xiaolaba/UNO-R1-R3-reset-circuitry/hack/UNO_Rev1_2_3_mod.pdf

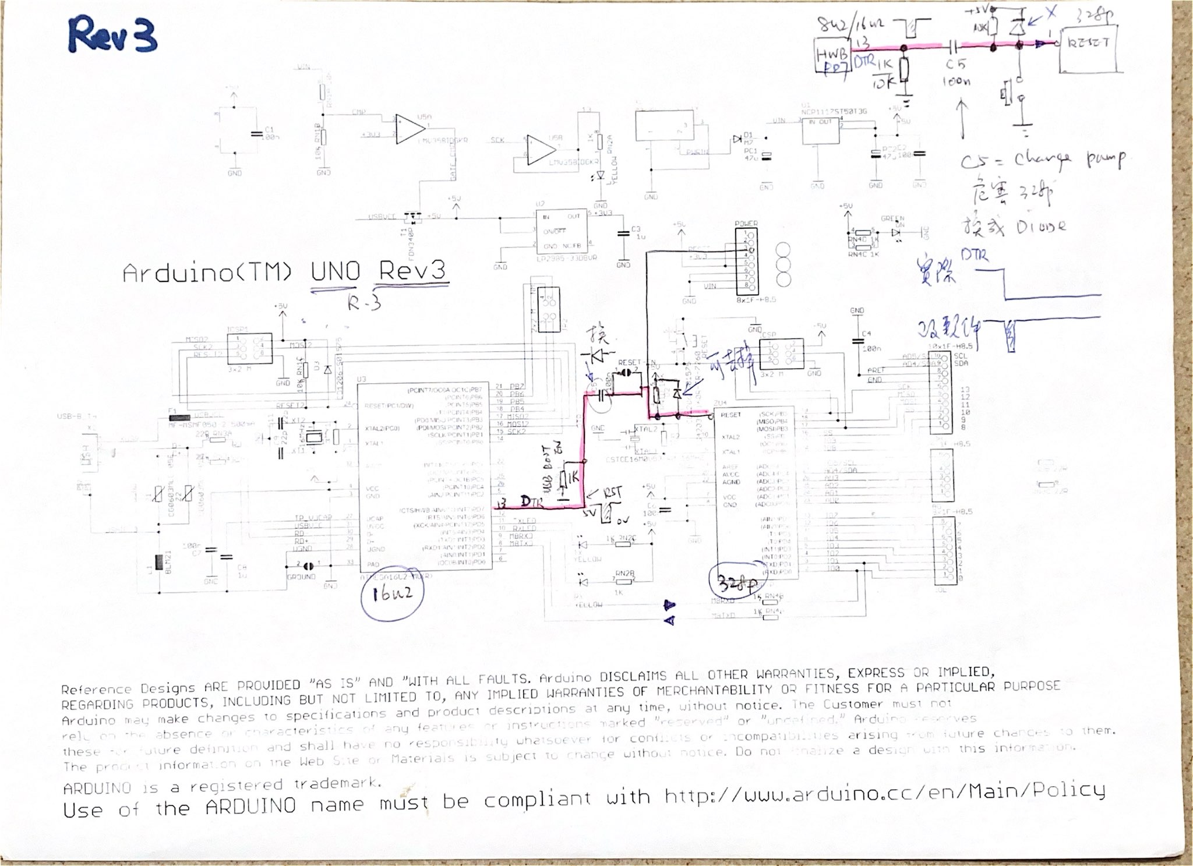
[picture p12: figure]

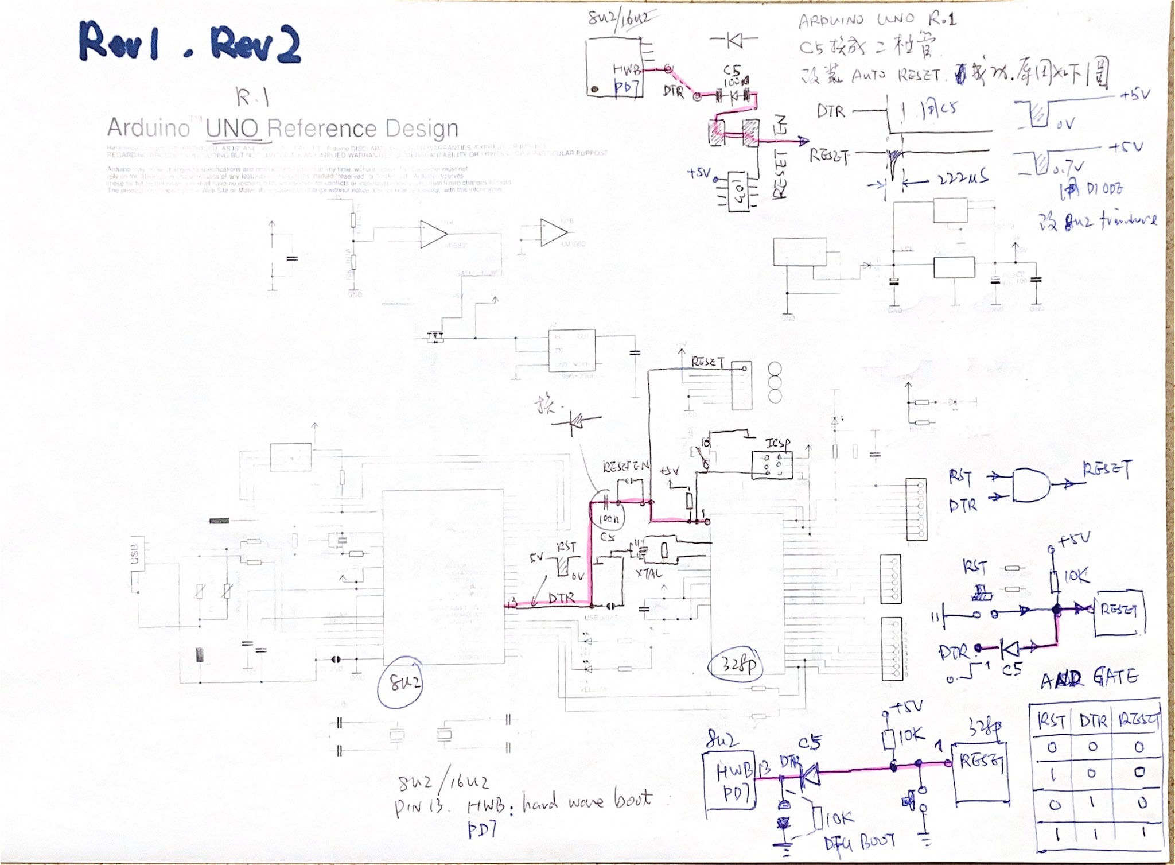
[picture p13: figure]
